OrebroUniversity/yumi/gazebo_mimic/README.md

Controllers for the Velvet Fingers 2 gripper. The gazebo_mimic_plugin was adapted from Gonçalo Cabrita (original at: https://github.com/ras-sight/hratc2015_framework) in order to have Gazebo support the mimic open/close joint of the gripper. AFAIK, starting at Gazebo 3.0 there should be native support and this plugin should be obsolete ...
