OrebroUniversity/yumi/yumi_description/meshes/coarse/body.stl

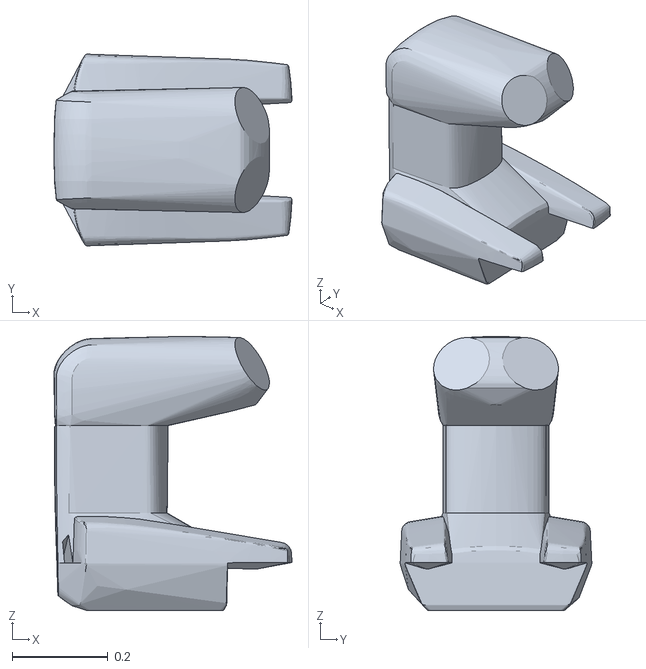
[picture p1: CAD file, 2016-04-11]
yumi_description/meshes/coarse/body.stl
0.496 x 0.399 x 0.571
