OrebroUniversity/yumi/yumi_description/meshes/gripper/coarse/finger.stl

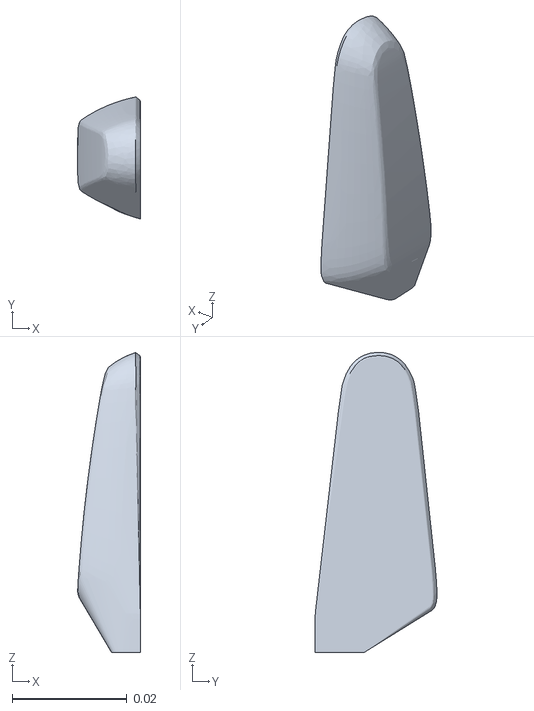
[picture p2: CAD file, 2016-03-17]
yumi_description/meshes/gripper/coarse/finger.stl
0.0109 x 0.0212 x 0.0522
