OrebroUniversity/yumi/yumi_description/meshes/gripper/finger.stl

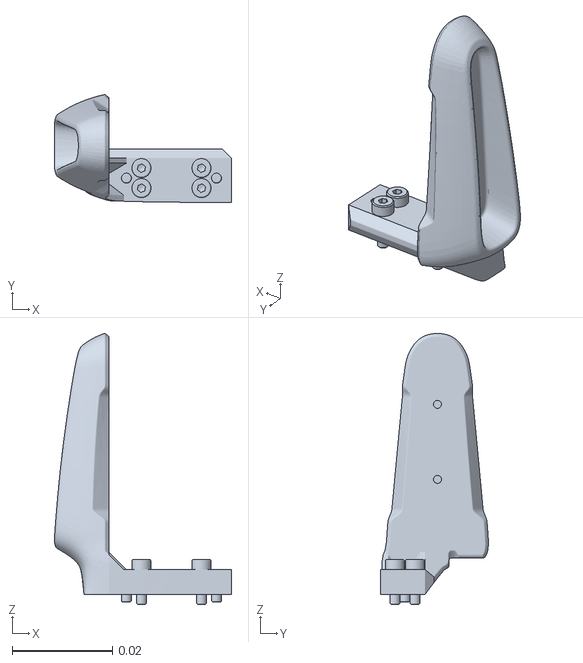
[picture p3: CAD file, 2016-02-26]
yumi_description/meshes/gripper/finger.stl
0.0354 x 0.0215 x 0.0542
