OrebroUniversity/yumi/yumi_description/meshes/link_5.stl

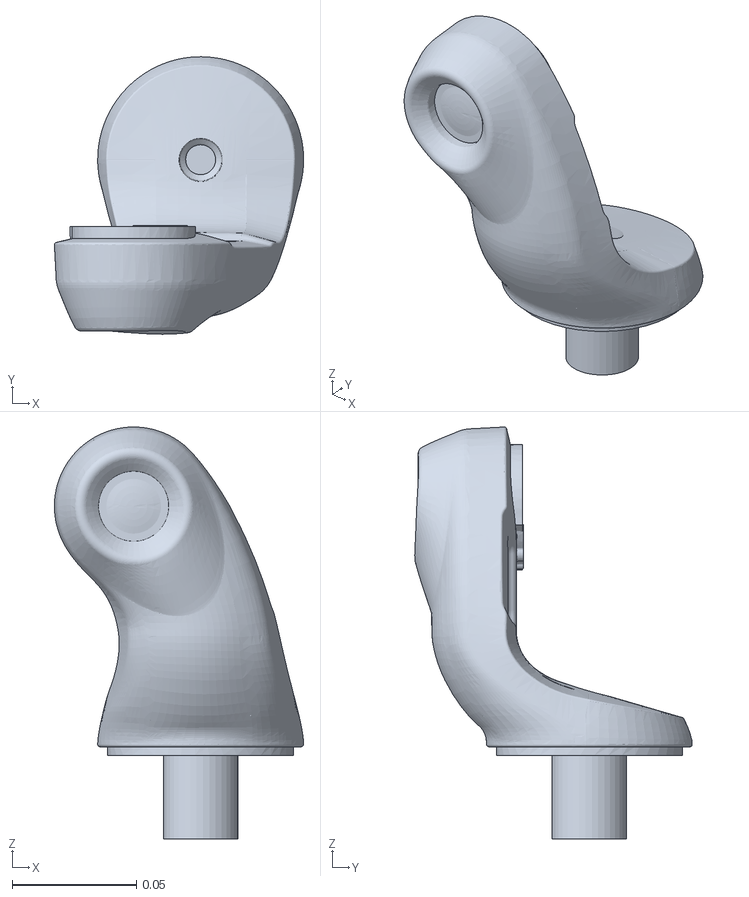
[picture p4: CAD file, 2016-02-26]
yumi_description/meshes/link_5.stl
0.1 x 0.112 x 0.166
