OrebroUniversity/yumi/yumi_description/meshes/coarse/link_1.stl

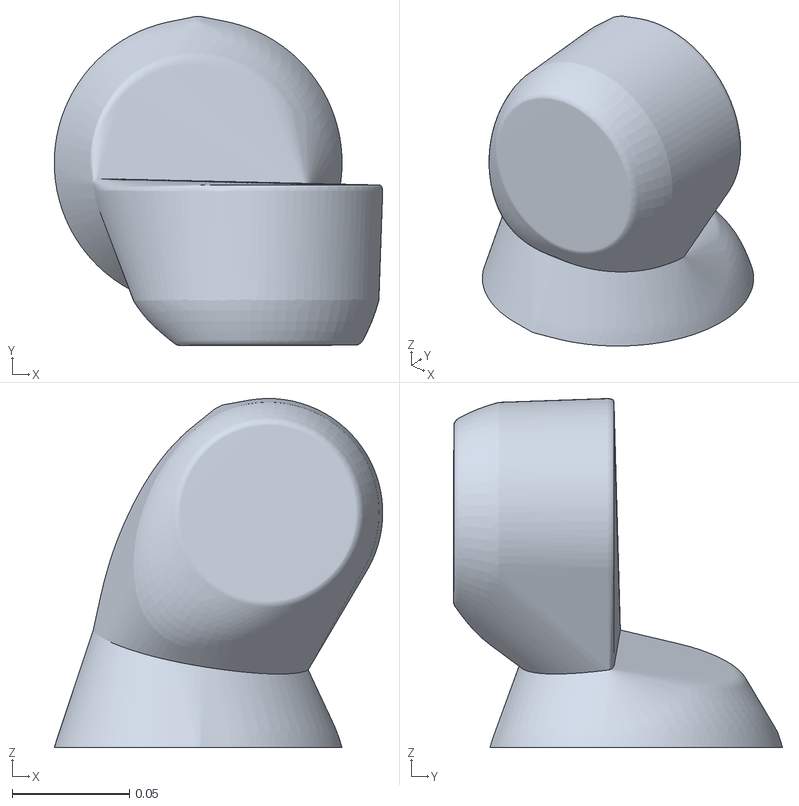
[picture p5: CAD file, 2016-03-17]
yumi_description/meshes/coarse/link_1.stl
0.14 x 0.14 x 0.149
