OrebroUniversity/yumi/yumi_description/meshes/link_6.stl

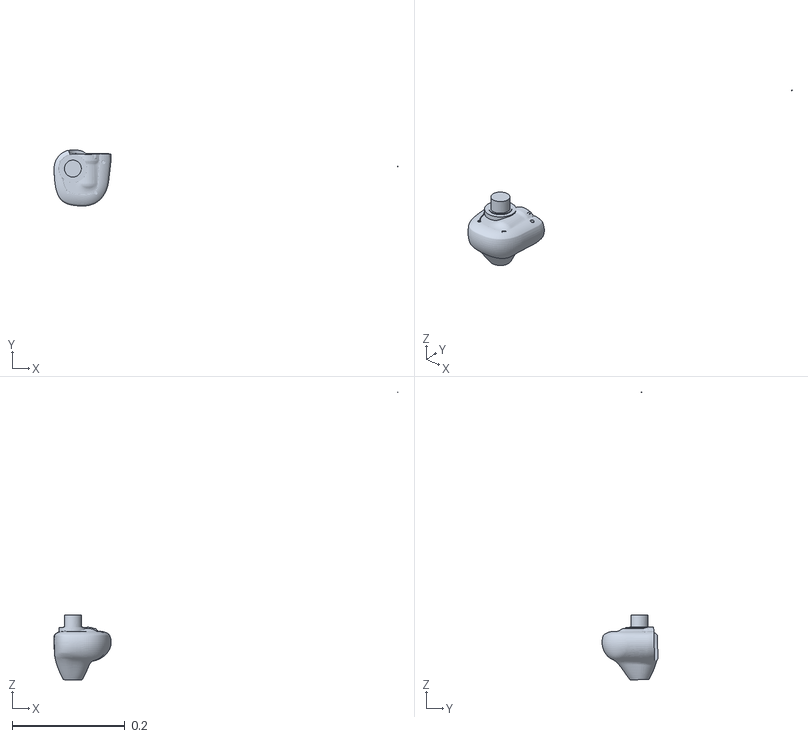
[picture p6: CAD file, 2016-02-26]
yumi_description/meshes/link_6.stl
0.61 x 0.0991 x 0.51
