OrebroUniversity/yumi/yumi_description/meshes/coarse/link_5.stl

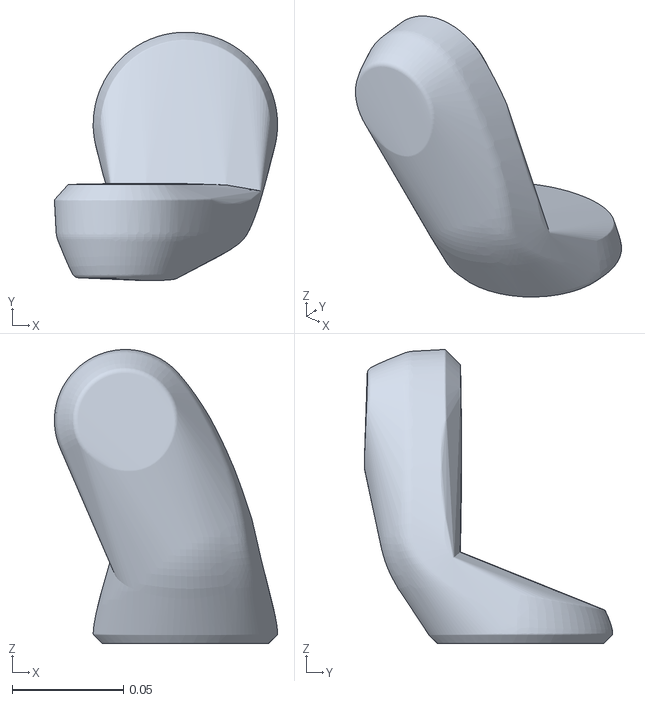
[picture p7: CAD file, 2016-03-17]
yumi_description/meshes/coarse/link_5.stl
0.1 x 0.112 x 0.132
