OrebroUniversity/yumi/yumi_description/meshes/link_7.stl

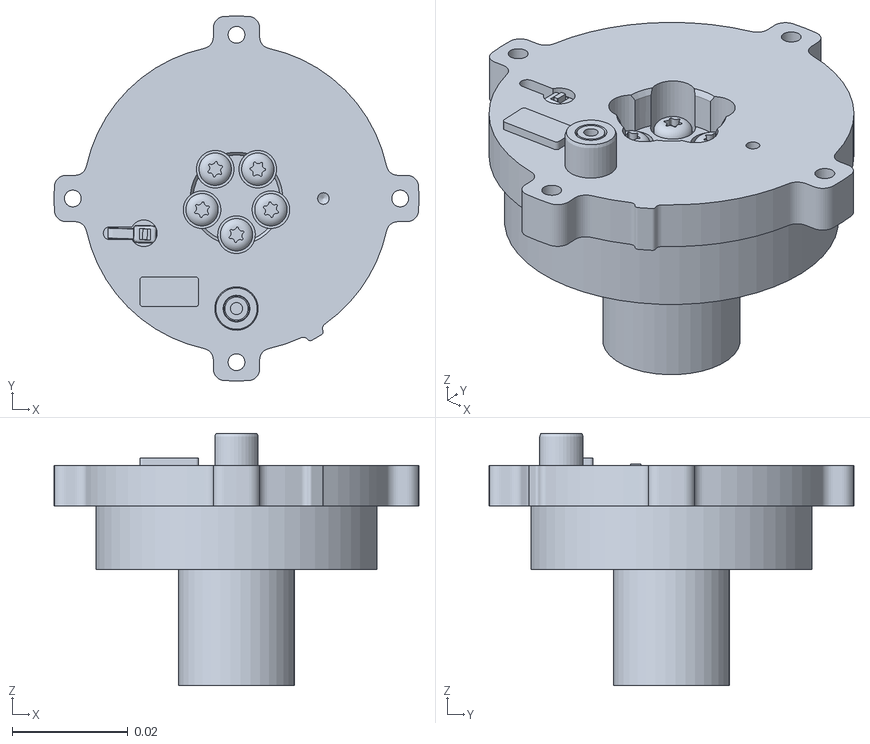
[picture p8: CAD file, 2016-02-26]
yumi_description/meshes/link_7.stl
0.063 x 0.063 x 0.0435
