OrebroUniversity/yumi/yumi_description/meshes/coarse/link_7.stl

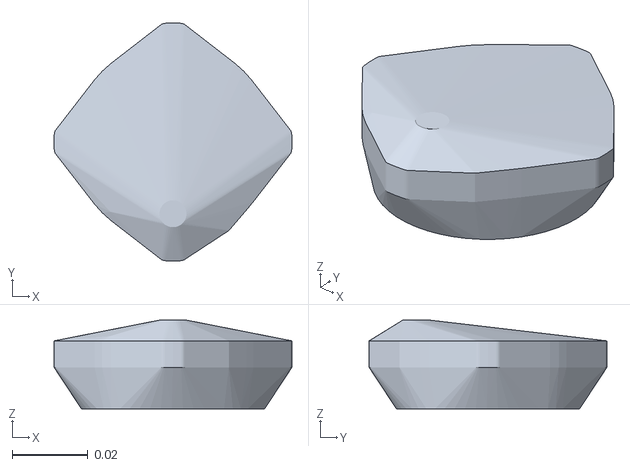
[picture p9: CAD file, 2016-03-17]
yumi_description/meshes/coarse/link_7.stl
0.063 x 0.063 x 0.0235
