OrebroUniversity/yumi/yumi_description/meshes/link_1.stl

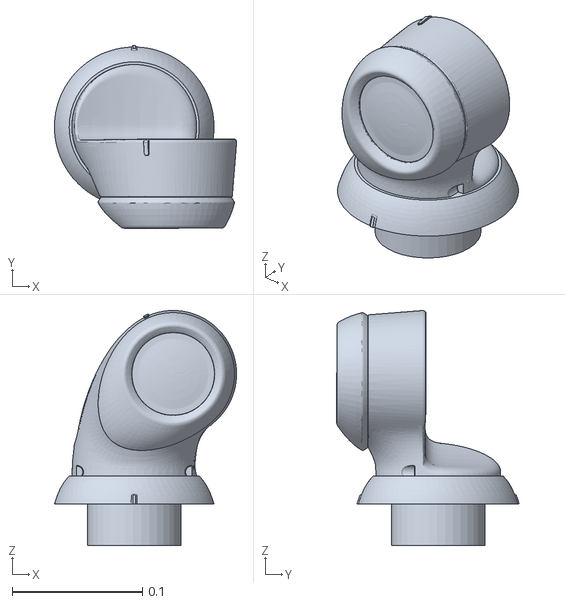
[picture p10: CAD file, 2016-02-25]
yumi_description/meshes/link_1.stl
0.14 x 0.14 x 0.181
