OrebroUniversity/yumi/yumi_description/meshes/coarse/link_6.stl

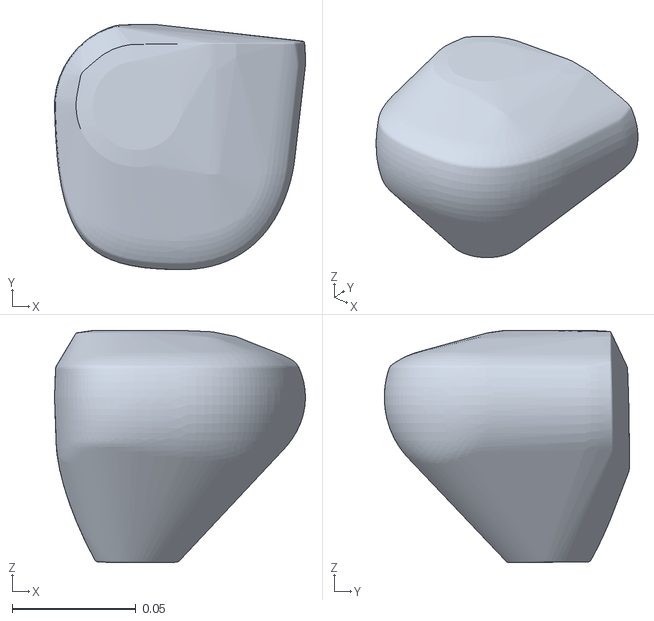
[picture p11: CAD file, 2016-03-17]
yumi_description/meshes/coarse/link_6.stl
0.101 x 0.0991 x 0.0937
