OrebroUniversity/yumi/yumi_description/meshes/link_3.stl

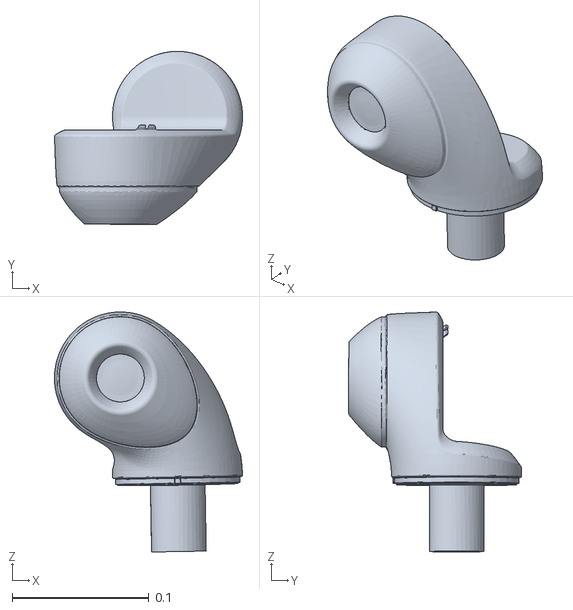
[picture p12: CAD file, 2016-02-25]
yumi_description/meshes/link_3.stl
0.137 x 0.127 x 0.175
