OrebroUniversity/yumi/yumi_description/meshes/coarse/link_3.stl

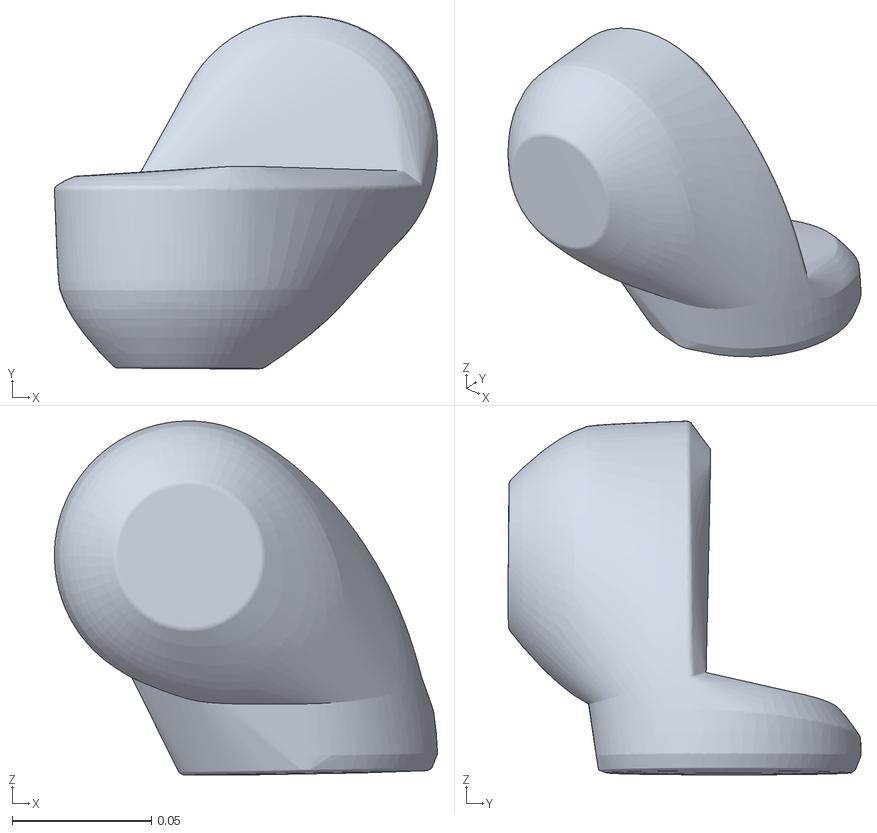
[picture p13: CAD file, 2016-03-17]
yumi_description/meshes/coarse/link_3.stl
0.137 x 0.127 x 0.127
