OrebroUniversity/yumi/yumi_description/meshes/link_4.stl

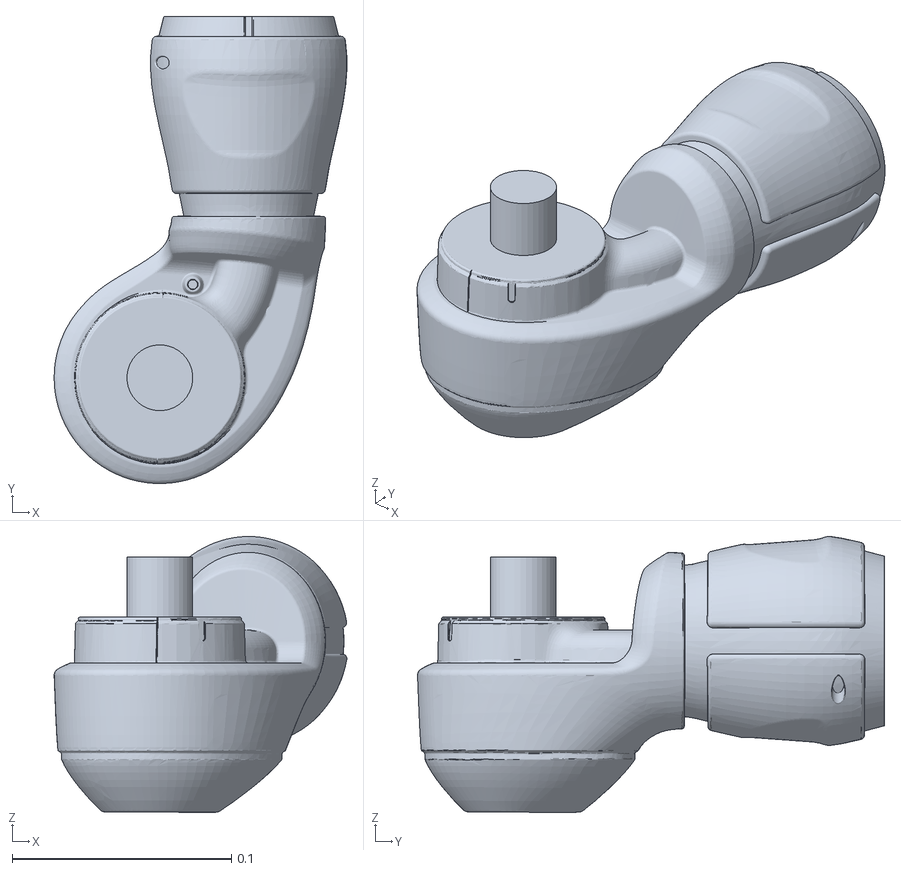
[picture p14: CAD file, 2016-02-25]
yumi_description/meshes/link_4.stl
0.133 x 0.213 x 0.126
