OrebroUniversity/yumi/yumi_description/meshes/coarse/link_4.stl

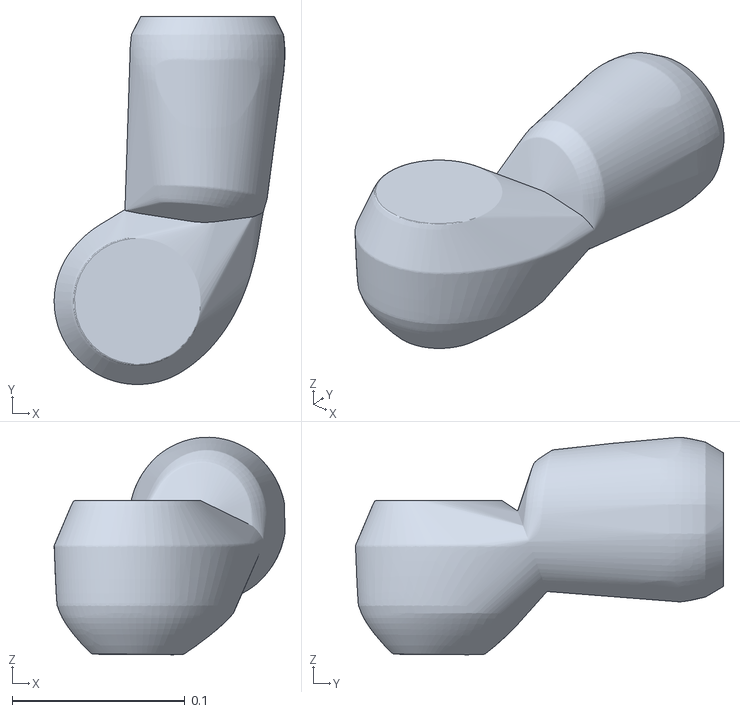
[picture p15: CAD file, 2016-03-17]
yumi_description/meshes/coarse/link_4.stl
0.133 x 0.213 x 0.126
