OrebroUniversity/yumi/gazebo_mimic/CHANGELOG.rst

^^^^^^^^^^^^^^^^^^^^^^^^^^^^^^^^^^
Changelog for package gazebo_mimic
^^^^^^^^^^^^^^^^^^^^^^^^^^^^^^^^^^

0.0.4 (2017-01-12)
------------------

0.0.2 (2017-01-10)
------------------
* fix for backcompatibility with gazebo
* the mimic plugin that we probably forgot to commit long time ago
* Contributors: Todor Stoyanov
