OrebroUniversity/yumi/yumi_launch/CHANGELOG.rst

^^^^^^^^^^^^^^^^^^^^^^^^^^^^^^^^^
Changelog for package yumi_launch
^^^^^^^^^^^^^^^^^^^^^^^^^^^^^^^^^

0.0.4 (2017-01-12)
------------------

0.0.2 (2017-01-10)
------------------
* minimal launch files for yumi in gazebo and online
* Contributors: Robert Krug, Todor Stoyanov
