OrebroUniversity/yumi/yumi_support/CHANGELOG.rst

^^^^^^^^^^^^^^^^^^^^^^^^^^^^^^^^
Changelog for package yumi_support
^^^^^^^^^^^^^^^^^^^^^^^^^^^^^^^^

0.0.4 (2017-01-12)
------------------

0.0.2 (2017-01-10)
------------------
* Initial import
