OrebroUniversity/yumi/(threads)

Thread 5 (2016-12-08):

yumi_description xacro parsing error on Ros Kinetic

neckutrek, 2016-12-08:
Hi,

Upon launching yumi_rviz.launch in kinetic the following happens:

    hiqp2016@AASS-CADA06:~/ros_workspace$ roslaunch yumi_description yumi_rviz.launch
    ... logging to /home/hiqp2016/.ros/log/97df3a0c-bd24-11e6-949d-000ffed19a26/roslaunch-AASS-CADA06-17359.log
    Checking log directory for disk usage. This may take awhile.
    Press Ctrl-C to interrupt
    Done checking log file disk usage. Usage is <1GB.

    xacro: Traditional processing is deprecated. Switch to --inorder processing!
    To check for compatibility of your document, use option --check-order.
    For more infos, see http://wiki.ros.org/xacro#Processing_Order
    deprecated: xacro tags should be prepended with 'xacro' xml namespace.
    Use the following script to fix incorrect usage:
            find . -iname "*.xacro" | xargs sed -i 's#<\([/]\?\)\(if\|unless\|include\|arg\|property\|macro\|insert_block\)#<\1xacro:\2#g'
    when processing file: /home/hiqp2016/ros_workspace/src/yumi/yumi_description/urdf/yumi.urdf.xacro

    xacro.py is deprecated; please use xacro instead
    started roslaunch server http://AASS-CADA06:33801/

    SUMMARY
    ========

    PARAMETERS
     * /joint_state_publisher/use_gui: True
     * /robot_description: <?xml version="1....
     * /rosdistro: kinetic
     * /rosversion: 1.12.6

    NODES
      /
        joint_state_publisher (joint_state_publisher/joint_state_publisher)
        robot_state_publisher (robot_state_publisher/state_publisher)
        rviz (rviz/rviz)

    auto-starting new master
    process[master]: started with pid [17374]
    ROS_MASTER_URI=http://localhost:11311

    setting /run_id to 97df3a0c-bd24-11e6-949d-000ffed19a26
    process[rosout-1]: started with pid [17387]
    started core service [/rosout]
    process[joint_state_publisher-2]: started with pid [17398]
    process[robot_state_publisher-3]: started with pid [17405]
    process[rviz-4]: started with pid [17424]
    [rviz-4] process has finished cleanly
    log file: /home/hiqp2016/.ros/log/97df3a0c-bd24-11e6-949d-000ffed19a26/rviz-4*.log`

gavanderhoorn, 2016-12-08:
Seems like it works correctly, no? The `xacro` message is just a warning at this point.

tstoyanov, 2016-12-20:
I also think we can live with this warning. Changing to the new xacro will probably break backwards compatibility, so let's wait for a more pressing reason to do it.

Closed 2016-12-20.

Thread 9 (2017-02-23):

yumi_hw/rapid/ros_control

juliamp22, 2017-02-23:
Hi,
I would like to know if ROS_motionServer file on yumi_hw is available or is going to be available. Now  I am usig yumi_support/rapid/ROS_motionServer file, but it Works with joint_traj_msg, different as msg_joint_data.

If not, I will modify the actual ROS_motionServer file in yumi_support directory.

Thanks for all,

Júlia

tstoyanov, 2017-02-23:
Hi Julia,

when using yumi with a ros_control interface we had to do things a little bit differently from the legacy MoveIt interface. The legacy interface requires one state server and one motion server for each arm. The ros control interface only uses one state server for both arms. This is done in a tight loop with the corresponding hardware interface driver: we send the current joint states from RAPID to the interface node and then block and wait for the interface node to send us back the next joint commands. Unlike the legacy interface, we don't support trajectory download. The robot is at all times controlled by the ros_control node and requires constant commands.

To make this work, also note that you need to download our fork of industrial_core, as there is a small but very necessary change in the number of joints we are communicating between the nodes.

Hope that helps.
Todor

Closed 2017-06-30.

Thread 10 (2017-03-05):

what is the relationship between yumi_support/rapid and yumi_hw/rapid/ROS_control ? can I only use the former one instead of the latter one?

JJHu1993, 2017-03-05:
what is the relationship between    yumi_support/rapid    and     yumi_hw/rapid/ROS_control ?
Because I can understand the yumi_support/rapid files: each arm have a motion server and state server unlike the files in yumi_hw/rapid/ROS_control which didn't contain a motion_server.

So can I only use the former one: yumi_support/rapid?

tstoyanov, 2017-03-09:
yumi_support/rapid contains modules for running trajectory downloading to the robot. This is the preferred way to interface if you are using move_it and trajectory action interfaces.

The yumi_hw/rapid folder is used if you are setting up a ros_control hardware interface. In that case you are directly giving control setpoints, instead of downloading a trajectory. Commands are executed immediately, and feedback sent on the same connection object back to the ROS side. This is the preferd mode for running ros_control controllers. At the moment, this interface runs at about 10Hz.

That said, the moveit interface has not been extensively tested, so there might still be bugs in there. I also need to check if I have uploaded the latest versions from our robot to the repository.

Closed 2017-06-02.

Thread 11 (2017-03-12):

Split ros_control hardware interface arguments for arms and gripper

rtkg, 2017-03-12:
yumi_description/urdf/yumi.urdf.xacro should take two arguments such that the hardware interfaces for arms and grippers can be set independently.

YoshuaNava, 2017-06-14:
Hello Robert,

I added this to our KTH fork yesterday. I'll push it tomorrow and post the link to the commit.

Closed 2018-01-17.

Thread 14 (2017-06-30):

Torque interface

khoramshahi, 2017-06-30:
Hi there,

I just wanted to know if there is an available (plug-and-play) torque interface for Yumi robot.
I would like to send joint torque commands, and also be able to read external force/torques applied to the robot.

Thanks for your help and sorry if this is irrelevant to your repository.
Mahdi

tstoyanov, 2017-06-30:
Hi Mahdi,

unfortunately that's not a feature we can do anything about at the moment. The interfaces to the robot from the manufacturer's side don't at the moment allow controlling or reading the joint torques. If this changes at some point, we would of course be very eager to add this support :)

T.

khoramshahi, 2017-06-30:
Thanks for your quick response.

Closed 2017-06-30.

Thread 16 (2017-07-12):

Issue with "yumi_moveit_config/launch/demo_online.launch"

stinor, 2017-07-12:
Hi

We are having the following issue with both the simulated robot in robot studio and the actual yumi robot. When launching the "yumi_moveit_config/launch/demo_online.launch" the following error occurs.

The "right_arm/joint_trajectory_action" and "left_arm/joint_trajectory_action" clients fail to connect as shown in the image below.

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

Not quite sure what is wrong here as we have followed the instructions from the wiki and issues list.
We are using the RAPID files from the "src/yumi/yumi_support/rapid" folder as we are trying to control the yumi robot using the moveit rviz gui interface.

tstoyanov, 2017-07-12:
Hi,

I am afraid we might not be able to help you out much. The moveit support is a direct port from the abb_driver in ros-industrial, with very minor modifications. I did that as a first step to developing the ros_control drivers and did not debug it thoroughly. In fact, I am pretty sure the RAPID drivers that you are using would not move all joints of the robot correctly, so be very careful when testing...

I don't think any of the other maintainers are using moveit to control the robot either, so I think you might need to do some digging and debugging. I remember it sometimes took a very long time to bring up the planning scene, which would mess with the robot controllers. Check if the config uses the full robot meshes or if you are using the coarse meshes. And please post what you find here and I will try to help as I can.

T.

stinor, 2017-07-13:
Hi

We have managed to get this working now using the two steps below.
We were initially missing step 1 below which is what starts the industrial_robot_client which contains the joint_trajectory_action messaging that was previously missing.

1. From the terminal launch "robot_interface.launch" file as shown below. Ensure the correct robot ip   address is set in this file first.
 "~/catkin_ws/src/yumi/yumi_support/launch$ roslaunch robot_interface.launch"

2. Now in a separate terminal launch the online moveit demo as shown below.
  "~/catkin_ws$ roslaunch yumi_moveit_config demo_online"

We are now able to play around with the moveit.rviz GUI robot and see the actions translated onto the actual yumi robot  and the simulated yumi robot on robot studio.

Cheers

Closed 2017-07-13.

Thread 20 (2017-07-25):

Instructions for setting up grippers in RobotStudio

stinor, 2017-07-25:
Hi

Thank you for your help so far. I have got the two arms working (with robot studio simulated robot and actual robot) and now trying to get the grippers working but I think I'm missing some instructions or some information. Are there any special instructions for setting up the grippers in RobotStudio for this package.

I have loaded the gripper RAPID code from the "yumi/yumi_hw_rapid/GRASP" folder.
There are no errors when I run the "RAPID->Check Program" function in RobotStudio.
However, when I do a warm restart a couple of "Alias Define" errors are reported for the "HandDriver_left.HandSetupChirality()" and "HandDriver_right.HandSetupChirality()" procedures.
These are shown in the picture below.

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

**Assumptions**
The error seems to suggest that the aliases for "hand_ActualPosition_L", "hand_ActualSpeed_L", "hand_SysState_L" etc. need to be setup by defining their respective signals through the IO Configuration in RobotStudio. From what I can see, about 20 of these signals may need to be setup for each gripper.

**Question:**

1. Is my assumption above correct and if so are there any instructions or could you point me to anything that will help me with this. I have looked at some tutorials on how to setup IO signals for the gripper (eg. https://www.youtube.com/watch?v=6XoylqyZfFA) but nothing seems close enough to the aliases that are defined here. It seems I may also need to know what to map these aliases to.

2. If my assumption is wrong, could you point me in the right direction.

 Much appreciated!

tstoyanov, 2017-07-25:
Hi,

afaik, no need to set up signals. At least I never did when I set up the grippers. Maybe @YoshuaNava can also give some input here on his experience of setting up. The hand driver code is a direct copy from an older release of the Smart Gripper robotware package. In principle, if you install the newest version you would not need any of the hand driver modules, but just the ROS_ modules. As the API of Smart Gripper is constantly changing though, you might need to re-name functions. What version of robot ware and smart gripper are you using?

Let me know how you resolve this issue.

stinor, 2017-07-26:
Hi

I am using RobotWare version 6.05.00.01 and SmartGripper version 3.40

YoshuaNava, 2017-07-27:
Hello,

I will answer your questions below.

## Gripper tasks and modules
I usually set the grippers modules (and all other motion modules) as normal tasks, for safety reasons. Particularly, for using the grippers create the following tasks:

|          Task          |    TYPE    | Trust Level | Use Mechanical Unit Group |
|:----------------------:|:----------:|:-----------:|:-------------------------:|
|  T_GRIP_State          | NORMAL     |   SysFail   |                           |
|  T_GRIP_Motion         | NORMAL     |   SysFail   |                           |
|  T_GRIP_Motion_L       | NORMAL     |   SysFail   |                           |
|  T_GRIP_Motion_R       | NORMAL     |   SysFail   |                           |

After creating them, do a soft restart. Then, load the following modules into each of the tasks listed:

|                     File                     |          Tasks         |  
| -------------------------------------------- |:----------------------:|
| RWS/ROS_common.sys                           |  T_GRIP_State, T_GRIP_Motion, T_GRIP_Motion_L, T_GRIP_Motion_R |
| RWS/ROS_messages.sys                         |  T_GRIP_State, T_GRIP_Motion, T_GRIP_Motion_L, T_GRIP_Motion_R |
| RWS/ROS_socket.sys                           |  T_GRIP_State, T_GRIP_Motion, T_GRIP_Motion_L, T_GRIP_Motion_R |
| Grippers/Gripper_motionServer.mod            |  T_GRIP_Motion         |
| Grippers/Gripper_stateServer.mod             |  T_GRIP_State          |
| Grippers/GripperMotion_left.mod              |  T_GRIP_Motion_L       |
| Grippers/HandDriver_left.sys                 |  T_GRIP_Motion_L       |
| Grippers/GripperMotion_right.mod             |  T_GRIP_Motion_R       |
| Grippers/HandDriver_right.sys                |  T_GRIP_Motion_R       |

The RWS and Grippers folders, containing the RAPID code, are the ones that appear here:

https://github.com/OrebroUniversity/yumi/tree/feature-egm/yumi_hw/rapid

*Note*: the main feature developed in that branch is the support for Externally Guided Motion (EGM), an interface for real time control. If you clone it and try to build it without the corresponding libraries provided by ABB, it will fail. Hence, if you need the scripts, clone the repo, feature-egm branch, out of your ROS workspace and just access the relevant folder _yumi_hw/rapid/_ to get the scripts.

## Signals

I haven't set any particular set of signals, just worked with the ones that come pre-set in YuMi by default. However, if you do need to set them, you can find a list of them after you unzip any of our firmware backups, as:

https://github.com/OrebroUniversity/yumi/blob/feature-egm/yumi_support/firmware_backups/500693_EGM_AllJoints_BothGrippers_NormalTasks.zip

And checking the file SYSPAR/EIO.cfg

Hope this helps,
Yoshua

PS: I have been writing a tutorial about YuMi firmware setup, but it's not ready yet:
https://github.com/kth-ros-pkg/yumi/wiki/Firmware-setup

stinor, 2017-07-31:
Hi Yoshua

Thank you for the information above.

I have setup the grippers as shown above using the rapid files from the feature-egm branch.
[https://github.com/OrebroUniversity/yumi/tree/feature-egm/yumi_hw/rapid](url)

I have also set up the signals using a backed up SYSPAR/EIO.cfg file from the [https://github.com/OrebroUniversity/yumi/blob/feature-egm/yumi_support/firmware_backups/500693_EGM_AllJoints_BothGrippers_NormalTasks.zip](url)

This is the procedure I ended up using.
I started from scratch by creating a new yumi controller and did a restore from backup using the backup from the above link. This essentially gave me all the required signals already setup from the SYSPAR/EIO.cfg file.

I then stripped out all the old arm and gripper tasks that came from the backup and manually re-added the arm and gripper tasks as shown above.

Note, that at this stage I have defined all the tasks as semi-static as I am still using the RobotStudio simulator and I want the tasks to start automatically on startup/reset.

When I do a "Rapid->Check Program" everything is ok. Now when I run the simulator, I no longer have the issues I had previously due to missing signal definitions. All tasks startup and run, however after 5seconds the GripperMotion_left and GripperMotion_right tasks both raise an exception. A picture of this is shown below.

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

From what I can see, the task is timing out in the Hand_WaitForExpectedState as it is not able to get the Hand_GetFingerState() successfully within the timeout period of 5s. The expectedState passed in is 6 which equates to STATE_ACTIONCOMPLETED. Hand_GetFingerState() returns the hand_SysState so it looks like hand_SysState is not being updated.

I am not sure whats going on beyond this now so again starting to suspect some configuration issue.

Note at this stage, I haven't started any of the ROS nodes on the ubuntu side. I am expecting the RAPID server tasks to be waiting for clients to connect. This is the case for the motion and state servers for the arms and grippers, however the gripper motion task is having this issue.

Would you have an idea of what is going on here.
Many thanks

YoshuaNava, 2017-08-03:
Hello stinor,
I haven't experienced this issue before. Have you been able to solve it?

I have a lot of tasks now, but if you could send me a backup of your current setup, I could test and debug it locally, probably in 1-2 weeks.

stinor, 2017-08-09:
Hi Yoshua

I will send you a backup of my current setup.

I haven't been able to solve this gripper issue yet on the simulator.
However, everything seems to be working on the real robot which I have been working with this last week.

Thanks

lz89, 2017-10-23:
@YoshuaNava How could you have the trust level option when using normal mode. In my case the trust level option won't be available if a task is set to normal.

ahmadwahab, 2017-11-19:
I followed the above instructions exactly and I run the RAPID check program I got no errors, however I'm still not able to communicate with the grippers and the when I run the programs Gripper_motionServer and Gripper_stateServer are waiting for connections.
Any help with this issue?

Thread 21 (2017-09-07):

how control the real yumi robot

LeonRobot, 2017-09-07:
hi, I am using the yumi_support and yumi_moveit_config.  when I use the deme_online.launch, I can accept the robot position, but i can't use the motion planning to control the robot move. And I also try use the "rostopic pub -1 /left_arm/joint_path_command trajectory_msgs/JointTrajectory "  to control the arm,  it doesn't work also.
So, what the problem it is?
Much appreciated!

tstoyanov, 2017-11-30:
Could you please give some more details about this issue? What branches are you using and what is running on the robot?

LeonRobot, 2017-12-18:
It was my fault, the  set up on the side of RAPID has something wrong.

Thanks for all.

beevabeeva, 2019-11-29:
Having the same issue I think. If you could detail the steps used to solve it (what did you change in the RAPID files?), that would be appreciated.

LeonRobot, 2019-11-30:
> Having the same issue I think. If you could detail the steps used to solve it (what did you change in the RAPID files?), that would be appreciated.
It has been a long time since then, and I have forgotten the problems at that time. This software is no longer maintained by Orebro University.  I used to refer to [kth-ros-pkg/yumi](https://github.com/kth-ros-pkg/yumi/wiki/Firmware) and [ethz-asl/yumi](https://github.com/ethz-asl/yumi/wiki/Setting-Up-YuMi-in-RobotStudio). I hope it will help you

beevabeeva, 2019-12-01:
@LeonRobot thanks. I opened issues on those repos too.

Closed 2017-12-18.

Thread 22 (2017-09-07):

An error occurred while establishing communication with the robot

LeonRobot, 2017-09-07:
hi, i use the the OrebroUniversity/industrial_core, but when i run the  roslaunch robot_interface.launch
it show the [ERROR] [1504762335.231789044]: Get unload pointer failed, buffer size: 0, smaller than byte size: 4
[ERROR] [1504762335.231843198]: Unload pointer returned NULL
[ERROR] [1504762335.231877206]: Failed to unload message joint: 8 from data[0]
[ERROR] [1504762335.231913226]: Failed to unload joint data
[ERROR] [1504762335.231945259]: Failed to initialize joint message

BUT if change from  “ static const industrial::shared_types::shared_int MAX_NUM_JOINTS =20”  to “static const industrial::shared_types::shared_int MAX_NUM_JOINTS =10”  in simple_message/include/simple_message/joint_data.h ,   It works.

I want to know why the ERROR occur, and  if  I need to change other Settings.
Much appreciated!

lz89, 2017-10-23:
I have the same issue.
I though the MAX_NUM_JOINTS should change to 20 for Yumi due to the discussion [here](https://github.com/ros-industrial/industrial_core/issues/147)
What I did was to clone the original industrial_core repo and check out the kinetic stable branch, then change the `MAX_NUM_JOINTS` from 10 to 20.
Then I get the error, but if I change back to 10, the `robot_interface.launch` under yumi_support folder works.

tstoyanov, 2017-10-23:
What branch of the yumi repo are you using? It may be that you have a different value for MAX_NUM_JOINTS on the ros side and the RAPID side. For a good overview on setting things up, I would also suggest checking through the wiki on the kth fork of this repo (https://github.com/kth-ros-pkg/yumi/wiki).

gavanderhoorn, 2017-10-23:
@tstoyanov: the instructions on those pages contain references to the EGM interface driver. Afaik that is (still) not publicly available.

lz89, 2017-10-23:
@tstoyanov I'm using the master branch for ROS side, but feature-egm branch for the RAPID side.
The reason I am doing this is that from the RAPID code under yumi_hw (master branch) only have:
ROS_motion_left.mod and ROS_motion_right.mod. I don't know how should I load these to the tasks: T_ROB_L, T_ROB_R, ROS_MotionServer_L, ROS_MotionServer_R (or only one motion server as you mentioned in another issue that the yumi_hw uses only one motion server for both arm). I did refer the the kth fork which to some extent is helpful but also introduce some confusion as the instruction is not completed and aim for EGM.

I have read through all the opened/closed issues in this repo as well as the ethz fork wiki. I am still confused. So would you please give me some advises about:
1. If I don't have EGM and want to use the direct control (NOT trajectory download), shall I use the yumi_hw under master branch of this repo.
2. If I use yumi_hw master branch, how to link the mod files to the tasks, and what tasks shall I create? I know how to create task and load the modules in the controller etc.
3. If everything is setup at RAPID side (robot), what shall I run in ROS side (PC) in order to establish the communication?
4. I assume I need to use ros_control package from the ROS to control and communicate with the robot? (Sry that I am not that familiar with this)

Thank you very much!

lz89, 2017-10-24:
Regarding the `MAX_NUM_JOINTS` issue, I think I found the answer from:
https://github.com/OrebroUniversity/yumi/pull/19

tstoyanov, 2017-11-30:
Hi @lz89 ,
1. If you want to do direct control and don't have EGM, you should look at the feature-ros-control branch. This does not offer MoveIt support: you would have to use ros_control controller instead (though it is possible to translate to action server, just needs some work)
2. In general, you should load the the ROS_common, ROS_messages and ROS_socket in all tasks (static). You should make a new task under either T_ROB_L or T_ROB_R that loads the ROS_StateServer. You should then load ROS_motion_left to the main task in ROB_L and conversely ROS_motion_right to ROB_R. Loading the gripper tasks should be identical to the instructions on the KTH wiki.
3. If everything is running smoothly, you should be able to roslaunch yumi_launch yumi_pos_control.launch. This should set up a position streaming interface. I have not tested this extensively. The yumi_vel_control.launch at the moment loads a custom controller that you probably do not have installed. If you modify it to load the joint_trajectory_vel_controller instead, this should give you a nice velocity control interface.
4. Yes. You would need to get  some familiarity there.
5. That should be done by writing a cartesian ros_control controller. There might already be some examples of that available.

LeonRobot, 2017-12-12:
@tstoyanov @lz89 @gavanderhoorn Thank you for your answers. I think this problem has been solved.

Closed 2017-12-12.

Thread 23 (2017-09-14):

Confused about many different drivers

simonschmeisser, 2017-09-14:
Hi Everybody,

I'm sitting in front of a YuMi for some time now and wondering what driver would be best for us and where to take it from. We intend to use it for bin-picking and execute pre calculated trajectories (ie. no live feedback/realtime required). It has to be fast!

I read somewhere that the ABB_driver based joint_trajectory downloader approach is supposed to have a long (several seconds) delay before starting trajectory execution. Is that true? Is it faster for short/sparse trajectories (number of points, not distance)?

I started using the drivers from https://github.com/OrebroUniversity/yumi/tree/master/yumi_hw master branch and it is moving using MoveIt!. However there is a very notable delay before it does (ca 1s) and sometimes it moves joint6 (the wrist) to 0 instead of the intended position. I'm not sure if this is a ros_control issue (I doubt it) or related to yumi_hw.  Also sometimes it hangs at startup and the joint_state_controller does not come up.

I feel safer about using the trajectory downloader approach actually because we use that for other brands already but of course I worry about the long delays. What do you think? Can you point me to whatever branch and version you recommend?

Does egm also work for position control or just velocity control?

Thanks a lot
Simon

simonschmeisser, 2017-09-16:
Small update, I haven't seen any real erroneous movements any more using the position controlled driver from yumi_hw master. I also have the gripper running using the code from feature_egm branch (using fewer locks/mutexes seems to be the main difference).
Delay before execution is somewhat acceptable now at 100% controller velocity override and aiming for slower speed in the trajectory parametrization (25%). However while some movements are nice and smooth, others are quite jerky, showing lots of stop and go motion. I have two days remaining next week to get a nice presentation for our potential customer, what do you think would be the best approach? For other robots we usually send trajectories with only two points (if collision free) but I read that for this driver I need more dense ones. I currently just interpolate 100 steps, no matter what distance. What step size do you recommend? How does it depend on velocity? Doesn't ros_control interpolate itself?

Should I try one of the egm branches or is that to complicated to setup?

@tstoyanov @rtkg @YoshuaNava sorry for spaming, but any opinion? Please :)

tstoyanov, 2017-09-18:
Hi Simon,

terribly sorry for the long wait, but we are overloaded at the moment. I am afraid that you are already using the best currently available solution to your issue... There are indeed several options for the yumi drivers, which are:
* trajectory download and then execution in RAPID. This we have tested (briefly) with MoveIt, and seems to work ok. There might be an issue with joint 7 (elbow joint), which I would have to double-check, and this might explain the strange motions you see. This is in the main branch.
* direct joint control over ros_control and a native RAPID interface. This should work without any delay, but in order to use it with moveit you would need a tracking controller. This should be possible to do, but I have not tried it and I am not sure how well the tracking controller will work. There are also a lot of issues with re-starting the robot and mutex initialization in this option.
* the last option is ros_control over EGM, which should work best. You would again need a tracking controller, but at least this option should give you better tracking. You would however need an EGM license from ABB in order to use this on the robot.

sorry couldn't help more.
T.

simonschmeisser, 2017-10-04:
Hi tstoyanov,

when I wrote this I was using option 2 (direct joint control over ros_control and a native RAPID interface). This was indeed starting movements without major delays but movement often got jerky and generally looked imprecise. I think issues were mostly related to a mismatch between trajectory point spacing and execution rate of these. (And then there were also the mutex and other issues)

I then switched to using classical option 1, ie trajectory download based on abb_driver and this results in smooth and relatively speedy execution. However I still have (unpredictable) delays before execution of the trajectory starts. I assume this is due to internal collision checking in the yumi controller. Also trajectories are still slower than the designated max speed.

Do you know how to disable collision checking? Other settings that limit the velocity?

tstoyanov, 2017-11-30:
Hi Simon,
and sorry for the long delay. You probably have this figured out by now, but in case you did not, you can check issue #28 and the suggestions there. Regarding the collision checking, I think you can look at the MotionSup (motion supervision) level. If you set that to 0, you should be able to smash into things freely :)

Closed 2018-01-17.

Thread 24 (2017-09-22):

Unable to load yumi_moveit_config in mobeit setup asisstant!

janisa9, 2017-09-22:
I don't understand what i am doing wrong but i can't load yumi moveit config in setup asisstant to edit it.
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

Okay setup asisstant says that it is unable to locate urdf file yumi.urdf, although in yumi/description/urdf folder there is not file with such an extension. There are only yumi.urdf.xacro, yumi.xacro and some other files
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

Although usually files with urdf.xacro is possible to load in setup asisstant. So can anyone help me to selve this problem or try yourself if you have the same problem?

tstoyanov, 2017-09-25:
Hi,
this is a known issue, as I could not find a way to convince moveit to open the xacro files. Probably there is a better way to do it, but at the moment, I suggest to manually run xacro on the yumi.urdf.xacro, passing along as an argument the interface to the robot that you need (either position or velocity) like this:
`roscd yumi_description/urdf/
rosrun xacro xacro.py yumi.urdf.xacro prefix:=PositionJointInterface > yumi.urdf`

If you come up with a better way (maybe changing something in the setup assistant launch file?) please try it out, test it, and open a pull request. We'd be happy to have this issue solved.

cheers,
T.

gavanderhoorn, 2017-09-25:
A workaround for this could be to create two top-level wrapper xacros that define values for the `prefix` arg. Those could then be loaded into the MSA directly.

Note that on Indigo the MSA can load xacros that require Jade+ xacro since ros-planning/moveit#540. That may further simplify things.

Thread 25 (2017-10-03):

Yumi robot setup with 1 PC only

lz89, 2017-10-03:
Dear all,

Sorry to ask this question here which seems not directly related to the repository.
But this repo seems to be the only one for Yumi if I want to program yumi in Linux.

I realised there are several ways to control Yumi, but all of the options seems require Robotstudio on a Window PC and ROS on a Linux PC.

Is there a way to use a Linux PC ONLY to control the Yumi robot?

Thank you very much.

Regards,
Lin

lz89, 2017-11-15:
For future novice that just got your robot:
The ROS interface (this repo) is installed in a Linux machine which is connected to the robot service port (XP23) via its Ethernet port.
The RobotStudio, which is installed in Windows, will only be used when you upload the RAPID program to the robot. You will use the same service port, so you need to disconnect the robot from the Linux machine. When the program is uploaded, the RobotStudio is not needed during control.

If you don't want to switch back and forth, you can use a network switch to connect all three devices (robot, Windows PC and Linux PC) together.

Closed 2017-10-21.

Thread 27 (2017-11-02):

Support for lead-through mode

lz89, 2017-11-02:
Hi,

I wonder if there is a way to enable lead-through mode while the ROS server is running. Therefore, the ROS side can read robot's joint positions without sending command to the robot.
This is particular useful for demonstration as well as hand-eye calibration.

tstoyanov, 2017-11-30:
As far as I know, the answer is no...

YoshuaNava, 2018-01-17:
@lz89 We have been able to do this, thanks to @diogoalmeida.

So, what you should do is:
1. Put the robot in AUTO mode, with motors turned ON.
2. Run the RWS/EGM nodes on your computer.
3. Once the robot starts (the brakes usually make a "click" sound when this happens), change from AUTO to MANUAL mode in the FlexPendant.
4. On the FlexPendant, open the main menu, Jogging. Then, for each arm touch the option "Enable Lead Through"

If everything went well, you should be able to move YuMi's arms without the RWS/EGM connection being lost. Hence, all the joint states should be recordable.

NOTE: Be very careful when you enable lead through. If your robot is carrying any object, its arms will fall. Also, don't move the arms too fast, or you'll get [Motion supervision](https://github.com/kth-ros-pkg/yumi/wiki/Troubleshooting#motion-supervision) triggered.

Please let me know if this helps,

Yoshua

diogoalmeida, 2018-01-17:
Just note that this is a workaround and not a solution to the problem, and that it works *sometimes*.

Closed 2018-01-17.

Thread 28 (2017-11-07):

Joint velocity setting with yumi_support package

lz89, 2017-11-07:
I am using the yumi_support package and use topic `/xxxx_arm/joint_path_command` for control.
Now I am publishing just one point trajectory to the topic with desired joint values closed to the current value. If I leave the velocity field in the `trajectory_msgs/JointTrajectory` for the trajectory point, the robot moves smooth but slow. When I set the velocity field with a value, the robot moves very slow (slower than without setting it), even with a very large value for the velocity. I started the velocity with 0.1 and increase it to 500000, but there is not much different.

How can I increase the robot velocity when using the `joint_path_command` topic for the robot control?

gavanderhoorn, 2017-11-07:
Cross-posted to ROS Answers: [Velocity setting for topic joint_path_command](https://answers.ros.org/question/275277).

lz89, 2017-11-15:
I tried to modify the default speed in RAPID ([ROS_motion_right.mod](https://github.com/OrebroUniversity/yumi/blob/master/yumi_support/rapid/ROS_motion_right.mod#L39)).
Based on the ABB manual, there are a bunch of predefined speed that can be used:

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

I tried from v100 to v7000, the speed seems increase a bit from v100 compared to the original one (v10), but there is not much difference b/w v100 and v7000.
In addition, I tried vmax but an error occurred (not defined variable) when I run the RAPID program.

If you have any experience on this variable please comment what's the preferred and safe value.

tstoyanov, 2017-11-30:
Hi,
I have very little experience with this, but there can be many things at play. Are you running the robot in automatic mode? If you run in manual, it will certainly refuse to go at some of the very high speeds. Another thing you could check is how many trajectory points do you download and how close together they are. If they are closer together than the stop_mode distance, the robot might never have time to accelerate to the desired speed. The final thing I would suggest is to check what trajectory durations you are setting. I have a suspicion that this would actually be the determining factor (while move_speed is just an upper velocity bound).

Thread 29 (2017-11-23):

Gripper Connection Problem

ahmadwahab, 2017-11-23:
Hi,
I was able to install the ABB ros server on my Yumi robot, the server is working good for controlling the two arms using Orebro/yumi package. However I'm still having problems in connecting the grippers to the ROS server. I installed all the required files and modules for grippers control and I run the RAPID check program and I got no errors. The main problem is that the Grippers Motion Server and the Grippers State server are still not connected to the ROS server. Any help with this issue??

tstoyanov, 2017-11-30:
Hi,
I am answering also here for completeness sake. Try to run the yumi_gripper_node executable from the yumi_hw package. This should connect to the RAPID servers and should let you call open/close service calls for each hand.

ahmadwahab, 2017-11-30:
I did so several times with different files from different branches. Even I made an edit in gripper_node.h by try to change the port value but without any benefit. The problem is that the  yumi_gripper_node  is not correctly connected to RAPID servers. That's why I'm not able  to call open/close service calls.
The GRIP_State and GRIP_motion servers are never connected to my ROS PC client even after running the node.

YoshuaNava, 2018-01-17:
Hey,
In the KTH branch we made some modifications to the grippers RAPID modules. Check [here](https://github.com/kth-ros-pkg/yumi/tree/egm_modifications/yumi_hw/rapid/Grippers)

Those modules should be loaded into YuMi internal computer. For a guide on how to do that, see [Grippers and cameras setup](https://github.com/kth-ros-pkg/yumi/wiki/Firmware#grippers-and-cameras)

Hope this helps,
Yoshua

alibinjunaid, 2020-04-03:
@YoshuaNava Hi Yoshua, I have been following the instructions on the wiki page. The arm control is working, however the grippers tasks is giving error with no description when the rapid scripts from the yumi_hw/grippers/* is used. It would be great if you can point if i am something missing. Seems like rapid scripts for gripper seems to have an error. Thank you.

Thread 30 (2017-11-30):

Controlling robot in real time

sinamr66, 2017-11-30:
Hi All,

I am using the ROS interface for controlling the robot in real time (yumi_pos_control.launch), however, I am a bit confused. Everything seems nicely working except the fact that there is no topic for sending desired joint positions to the robot. I can read the current state of the robot from  /yumi/joint_states. But there is no other equivalent-topic for sending joint-positions to the robot.  Nevertheless, by running yumi_pos_control.launch, one can see /yumi/joint_trajectory_pos_controller/command which I can assumed that is used  for sending entire trajectory; am I right?

I would really appreciate if one can help me..:)

Best,
Sina

sinamr66, 2017-12-11:
Hi Guys,

So, I've tested  /yumi/joint_trajectory_pos_controller/command for sending the desired joint position and as expected it is super slow, particularly when the robot is controlled in the closed-loop with the real-measured-state. Can anyone help me?

Best,
Sina

Thread 32 (2019-04-22):

ikfast for yumi

RYANZYC, 2019-04-22:
Hello maintainer!I want to use ikfast instead of KDL algorithm to solve the kinematics of the manipulator.But when I follow the tutorial, the following prompt appears:
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

Thread 35 (2019-11-29):

Using Yumi with ROS + MoveIt!

beevabeeva, 2019-11-29:
We have managed to get as far as having MoveIt (+ rviz) get the correct current position of the robot. However, when trying to execute a path to a goal position, the robot does not move.

In addition, there are no gripper topics listed. MoveIT complains about not having the gripper states:
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

We followed the instructions (after digging around in other branches to find the required backups (addition-demo, two-grippers realtime) ). We found someone with a similar issue
(https://github.com/OrebroUniversity/yumi/issues/21) but there were no detailed steps listed to solve the issue.

Any help would be appreciated.

Sinchiguano, 2019-11-29:
You can try Yumipy, it is quite easy to move the robot with it, and it is also done in ros environment, so you can use Rviz and everything available from ROS.

beevabeeva, 2019-12-01:
Wr tried installing YumiPy but ran into a lot of issues- we are using ros-kinetic and the YumiPy docs explicitly say it has only been tested on jade. We might give it another go.
Thank you for linking your repo. It looks like it will be helpful. We will try it next week when we return from conference.

*To mods: Please do not close this issue yet, thanks.

Sinchiguano, 2019-12-05:
Well, I used yumipy with kinetic and even melody, and I did not have problem at all. But there is another package that I think it is built on top of OrebroUniversity/yumi, here you have the link:
https://github.com/kth-ros-pkg/yumi
I tried with that one, I did couple of applications and it works pretty well, the difference between the yumipy and the kth-ros-pkg/yumi is that you will have more capabilities to leverage the yumi robot with MoveIt if you go with kth package.

Best regards
Cesar

Thread 36 (2021-12-16):

- Portability on ROS1 Noetic.

giordy-sudo, 2021-12-16:
Hello, I have some issues when I compile (catkin build) this package :

- **yumi_hw**.

In particular error is :
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

Thanks a lot.

tstoyanov, 2021-12-16:
Hi,

this repository is deprecated. Check https://github.com/ros-industrial/abb_robot_driver for the new yumi drivers.

Closed 2021-12-16.
