OrebroUniversity/yumi/(commit log)

2016-02-23 skeleton of the yumi_description package
    [gazebo.urdf.xacro, materials.xacro, utilities.xacro, yumi.gazebo.xacro, yumi.transmission.xacro, yumi.urdf.xacro, yumi.xacro]
2016-02-25 some progress on the urdfs
    [link_1.stl, link_3.stl, link_4.stl, materials.xacro, yumi.gazebo.xacro, yumi.transmission.xacro, yumi.urdf.xacro, yumi.xacro]
2016-02-26 one arm done
    [link_5.stl, link_6.stl, link_7.stl, yumi.xacro]
2016-02-26 urdf seems to work
    [finger.stl, yumi.urdf.xacro, yumi.xacro, yumi_servo_gripper.gazebo.xacro, yumi_servo_gripper.transmission.xacro, yumi_servo_gripper.xacro]
2016-03-17 Add coarser meshes.
    [finger.stl, link_1.stl, link_3.stl, link_4.stl, link_5.stl, link_6.stl, link_7.stl]
2016-03-17 initial import of drivers for yumi. tested in simulation with robot studio. moveit seems to work fine with launch file demo_online
    [controllers.yaml, fake_controllers.yaml, joint_limits.yaml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]
2016-04-11 Add closer-fit coarse body.stl
    [body.stl]
2016-04-21 trying gazebo roscontrol but something is still off
    [controllers.yaml, yumi_nogrippers.urdf.xacro]
2016-04-28 joint states seem to be lost somewhere, otherwise connection is fine
2016-05-11 minimal working example, at least in simulation
    [controllers.yaml]
2016-05-13 HQP control seems to be working ...
    [controllers.yaml]
2016-05-13 demo node compiles ...
    [yumi_servo_gripper.gazebo.xacro, yumi_servo_gripper.transmission.xacro]
2016-05-14 modifications to RAPID side for velocity tracking
    [controllers.yaml]
2016-05-14 control works on robot
    [controllers.yaml]
2016-05-14 the rise of dual arm control
    [controllers.yaml]
2016-05-14 dual arm magic
2016-05-15 added camera launch file and edited dual arm demo scripts
2016-05-15 added scripts for separate arm movements
2016-05-15 gripper scripts
2016-11-01 modified launch files
    [yumi_servo_gripper.xacro]
2016-11-14 added launch files for sensors and updated calibration offsets
2016-11-16 played a bit with calibration
2016-11-18 yet another re-calibration
2017-01-10 clean up of hiqp / hqp stuff, fixing moveit
    [controllers.yaml]
2017-02-24 Added retrieval of joint states from egm interface
2017-03-10 Added egm velocity control mode to yumi_launch EGM control loop stops after 1.0s, reading of joint state is ok
2017-03-30 Bug fixes in EGM messages
    [yumi_hw_ifce_node.cpp]
2017-05-12 removing temporarily gripper node
2017-06-01 Adding a new file to test the grippers soon
2017-06-09 Some updates to make the grippers work, and file formats
    [controllers.yaml]
2017-06-09 Working code for using both grippers.
2017-06-10 Adding a set of effort, position and velocity controllers to the grippers
    The yumi_gazebo_vel launch file is working properly
    [controllers.yaml]
2017-06-10 Working velocity and position controllers simulation in Gazebo
2017-06-10 Changed the grippers interface to EffortJointInterface in the URDF. Deleted all grippers rws file. Updated the general launch files
    [yumi.urdf.xacro, yumi_servo_gripper.xacro]
2017-06-12 Fixing a bit the indentation of yumi_hw files
    [yumi_hw.cpp]
2017-06-12 Fixing the indentation of yumi_hw files. Debugging the integration of the grippers controllers
    [yumi_hw.cpp]
2017-06-12 Working control on both simulation and real robot. State of grippers visible in Gazebo, both cases.
    TODO: Set up MoveIt! interface
    [controllers.yaml, joint_limits.yaml, yumi.urdf.xacro]
2017-06-14 Some changes to make MoveIt! work with YuMi, not using the robot_interface.launch file, but rather the EGM interface
    [controllers.yaml, fake_controllers.yaml]
2017-06-14 Some small changes in the launch files and the moveit interface, to raise an actionserver
    [controllers.yaml, fake_controllers.yaml, joint_limits.yaml]
2017-06-14 Changes in the hw interface params sent from launchfiles
    [yumi.urdf.xacro, yumi_nogrippers.urdf.xacro]
2017-06-15 Integrating grippers into general state server, through the ROS basic dependency files
2017-06-15 MoveIt! interface fully working, with grippers service
    [controllers.yaml, joint_limits.yaml]
2017-06-16 New firmware for EGM + Grippers
2017-06-18 Changes in controllers structure to make it homogenous
    [controllers.yaml]
2017-06-19 New changes to separate controllers per arm
    [controllers.yaml]
2017-06-19 Added new script to separate left and right arm joint states. Now position controllers in Gazebo are working with MoveIt!
    [controllers.yaml]
2017-06-19 MoveIt! working with gazebo velocity and position simulations
    [controllers.yaml, joint_limits.yaml]
2017-06-20 Changes to make the EGM interface work with MoveIt!
    [controllers.yaml]
2017-06-20 Putting the joints remap scripts in yumi_hw
2017-06-20 Added extra joints to joint state controller so that the grippers don't get lost in the model while moving the real robot. Also added comments to EGM code files, and changed names of some variables t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
    [controllers.yaml]
2017-06-20 Adding individual joint velocity controllers and corresponding launch files
    [traj_controllers.yaml, velocity_controllers.yaml]
2017-06-21 Changed names of velocity controllers. Tested them.
    [velocity_controllers.yaml]
2017-06-21 Added group velocity controllers and new controllers test files
    [velocity_controllers.yaml]
2017-06-24 Adding a MoveIt! Python example
    [controllers.yaml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]
2017-06-24 Organizing yumi_description, and deleting old files
    [gazebo.urdf.xacro, materials.xacro, utilities.xacro, yumi.gazebo.xacro, yumi.urdf.xacro, yumi.xacro, yumi_nogrippers.urdf.xacro, yumi_servo_gripper.gazebo.xacro]
2017-06-26 Changes to make ridgeback_yumi pkg work
    [controllers.yaml, yumi.xacro, yumi_nogrippers.urdf.xacro]
2017-06-26 Code to test YuMi's low pass filter frequency
2017-06-26 Improving code for testing velocity controllers and the YuMi LPF
2017-06-27 Code for: Control loop frequency test, velocity controllers test
2017-06-28 Added both_arms move group, discovered a bug in EGM, which leads to jerky movement. Gonna check the RAPID files now
    [yumi.xacro]
2017-06-28 Implemented experimental HW interface and effort controller for the grippers
2017-06-29 New, experimental code for the grippers. Hopefully that will fix the current bug
    [traj_controllers.yaml, velocity_controllers.yaml]
2017-06-29 Position control of grippers
    [traj_controllers.yaml, velocity_controllers.yaml]
2017-06-29 RAPID files for grippers positiion control
2017-06-29 Effort control of grippers, RAPID files
2017-06-29 Auto stash before merge of "egm_modifications" and "origin/egm_modifications"
    Effort control of grippers
    [gripper_controllers.yaml]
2017-06-29 Effort control of grippers, ROS interface
    [traj_controllers.yaml]
2017-06-29 Backup of EGM+Grippers with calibration for 500693
    [SYS.cfg]
2017-06-29 Cleanup of the repo, everything set up for YuMi with EGM, effort controlled grippers, both in simulation and real life
    [traj_controllers.yaml]
2017-07-07 Revert "Merge pull request #13 from kth-ros-pkg/egm_modifications" revertin merge into master. PR is now in branch feature-egm (hopefully)
    This reverts commit e3b71a8f4bf1f8e69048eff7e7b5b6f3f5491120, reversing
    changes made to f4a6680138c808bed64ddcd5b7b29aa4d5398ad7.
    [SYS.cfg, controllers.yaml, gazebo.urdf.xacro, gripper_controllers.yaml, joint_limits.yaml, materials.xacro, traj_controllers.yaml, utilities.xacro]
2017-07-24 selective merge of feature-egm branch into master (w/o unreleased ABB code dependencies)
    [controllers.yaml, fake_controllers.yaml, gazebo.urdf.xacro, gripper_controllers.yaml, joint_limits.yaml, materials.xacro, position_controllers.yaml, traj_controllers.yaml]
2017-07-28 Some fixes to have abb_driver working with the grippers
    Ports for abb_driver: 11000-11002, 12000-12002
    Ports for grippers: 13000-13002
    Grippers node launches with the robot interface now
    MoveIt! wait for the left/right arm controllers directly
    [controllers.yaml]
2017-07-28 Some changes to make position control through RWS work
    [controllers.yaml]
